dmitrychepel/dcf77/doc/dcf77_bb.png

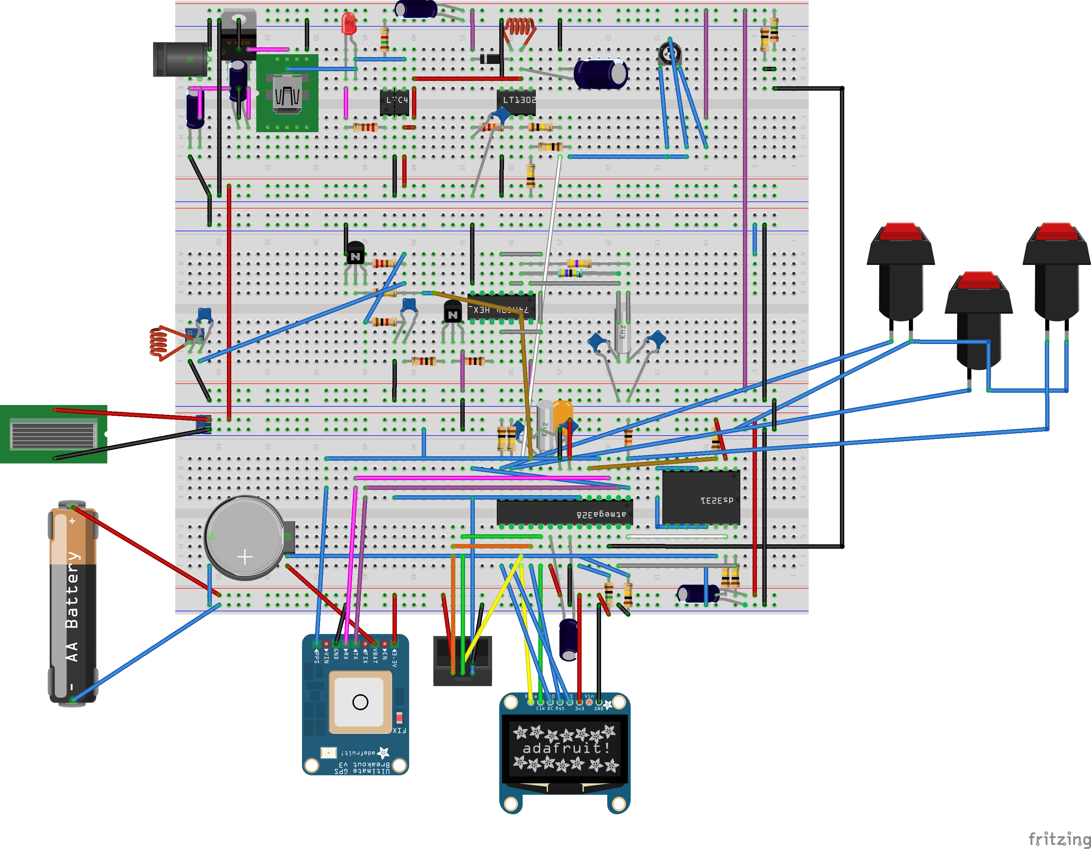
doc/dcf77_bb.png
