dmitrychepel/dcf77/doc/dcf77_печатная плата.png

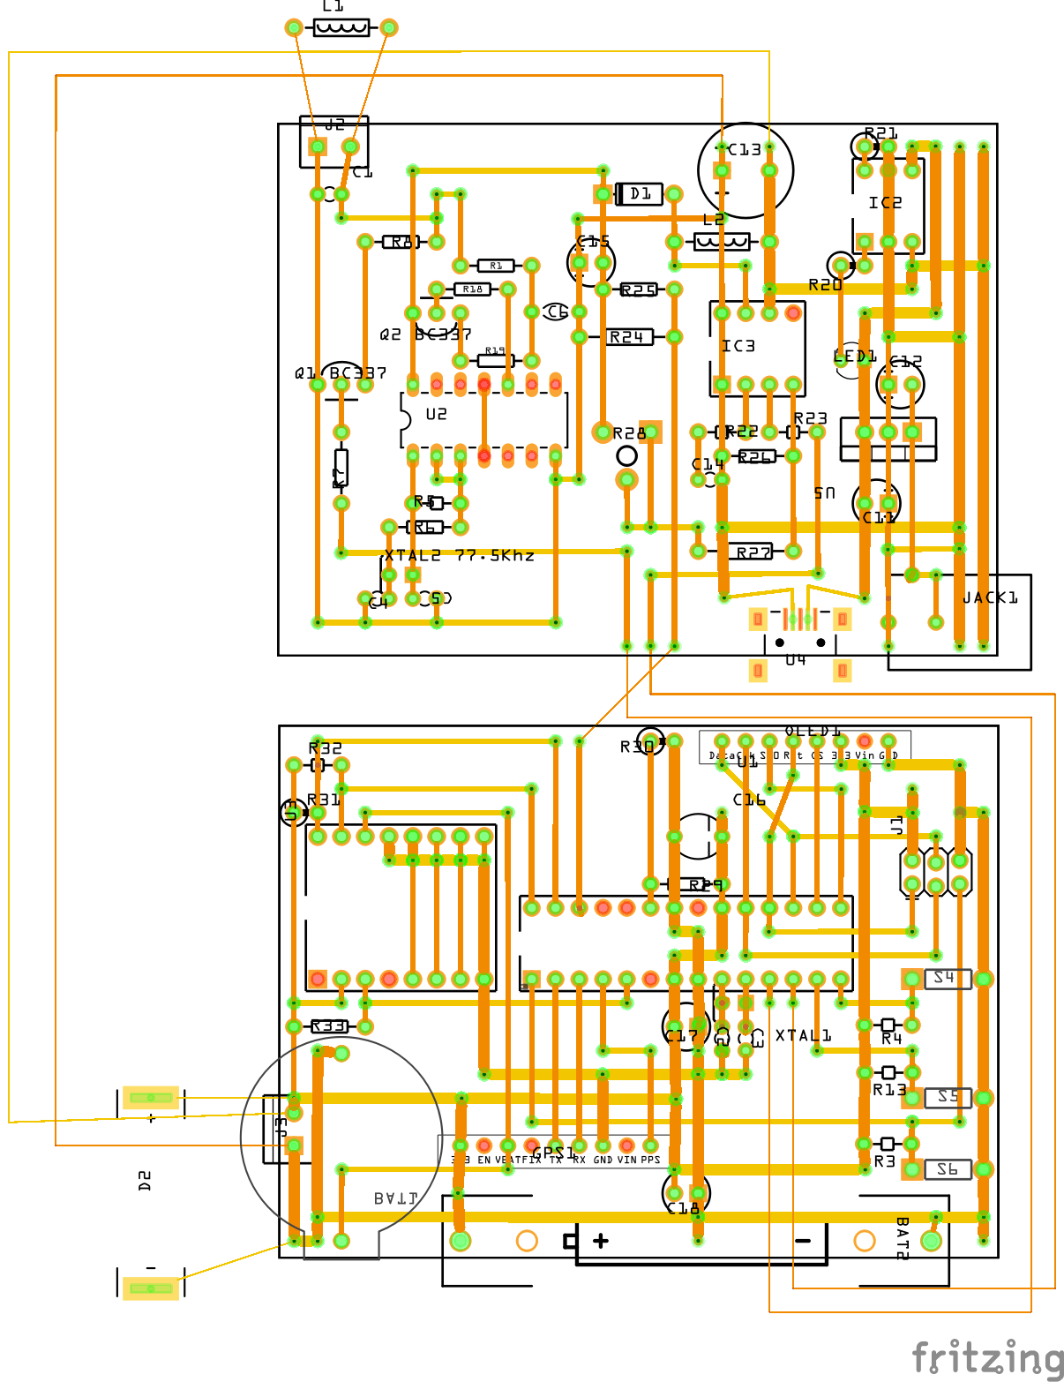
doc/dcf77_печатная плата.png
