dmitrychepel/dcf77/doc/dcf77_схема.png

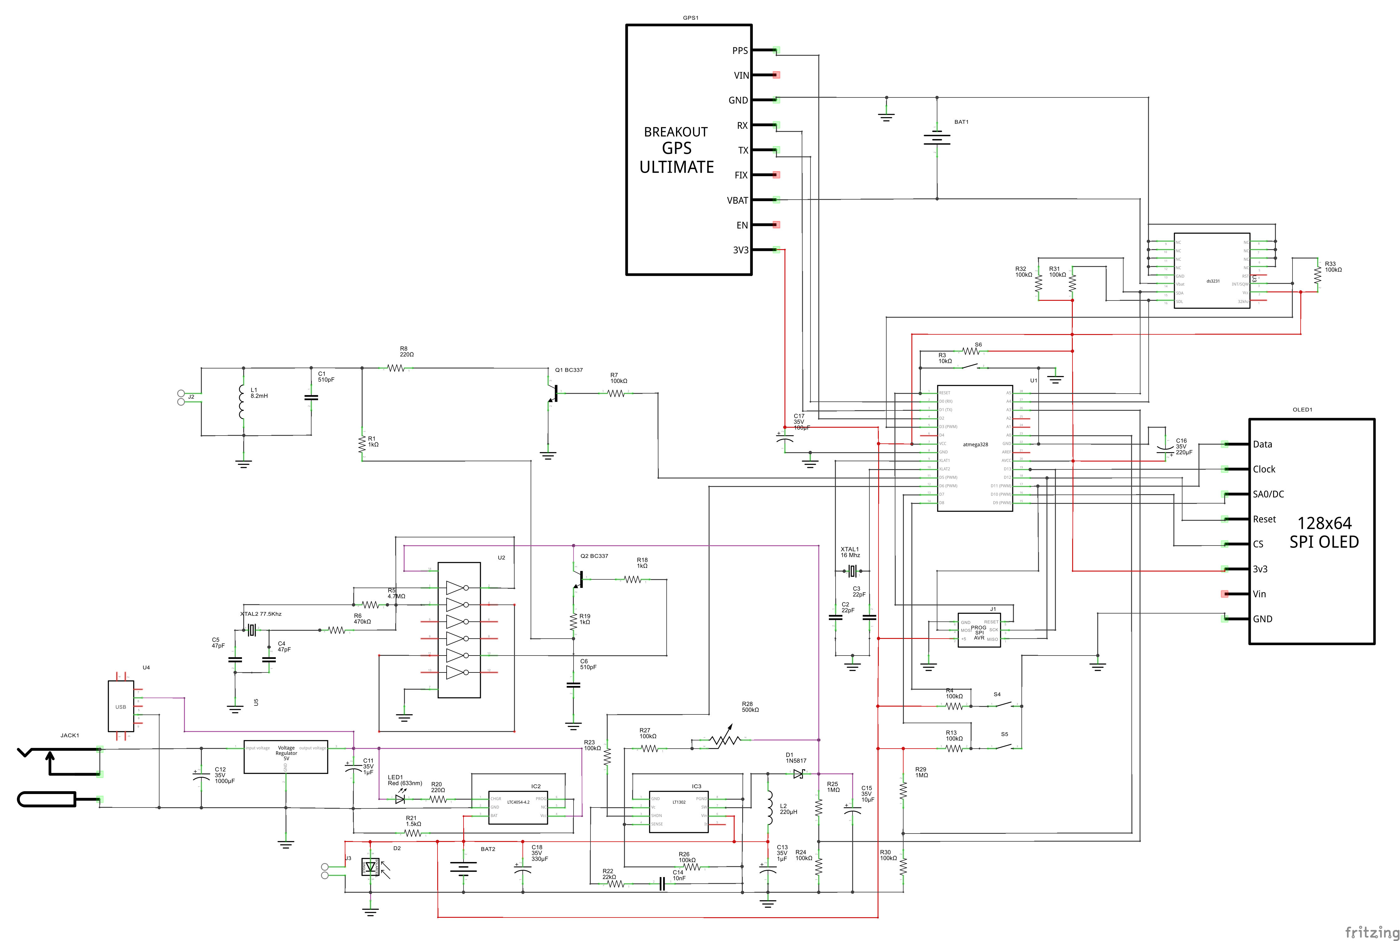
doc/dcf77_схема.png
