dmitrychepel/dcf77/schema/dcf77_v22_печатная плата.png

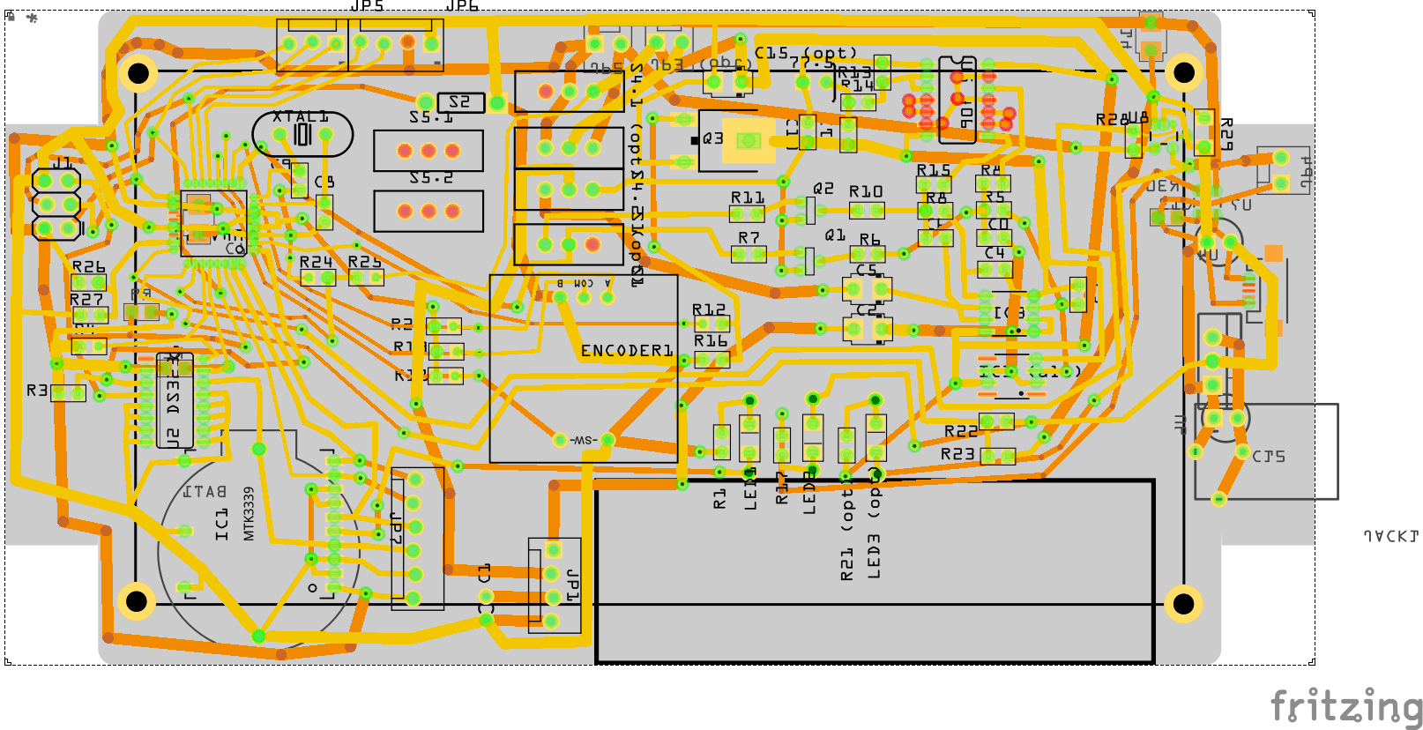
schema/dcf77_v22_печатная плата.png
