dmitrychepel/dcf77/doc/dcf77_first_step00.png

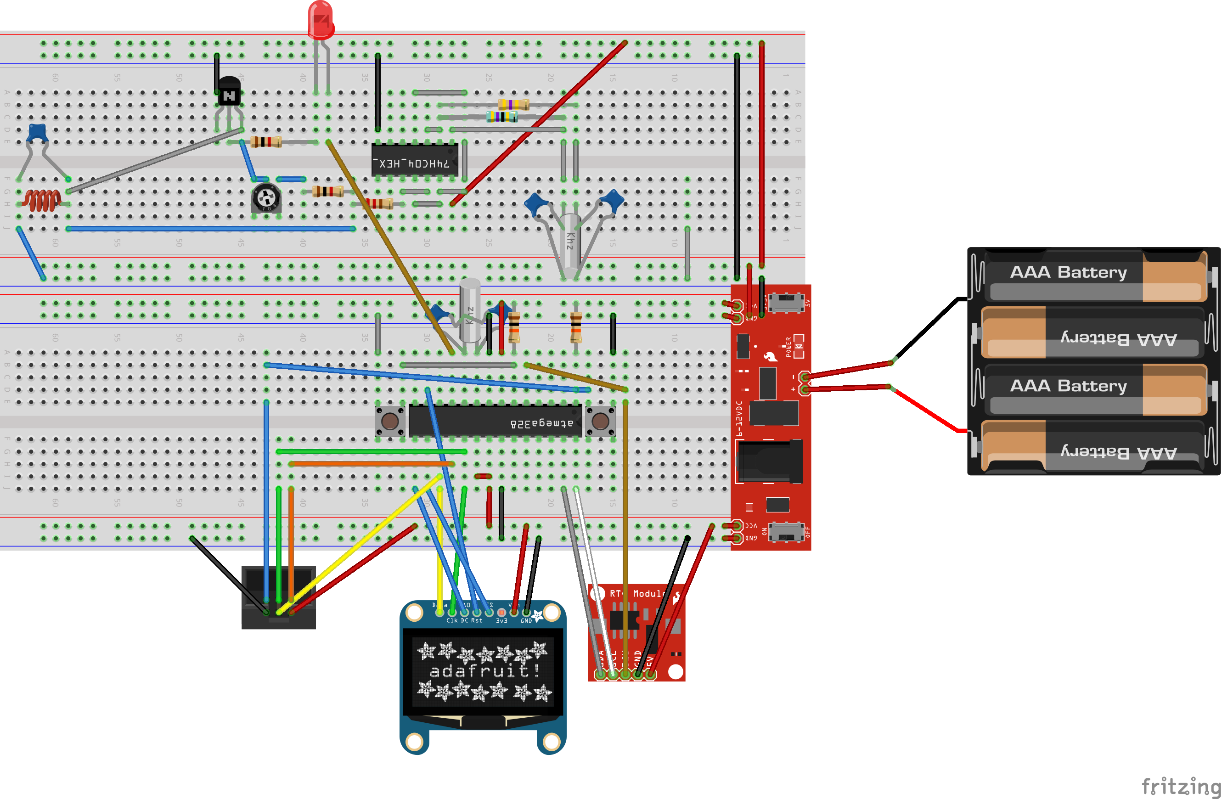
doc/dcf77_first_step00.png
