dmitrychepel/dcf77/doc/dcf77_first_step0.png

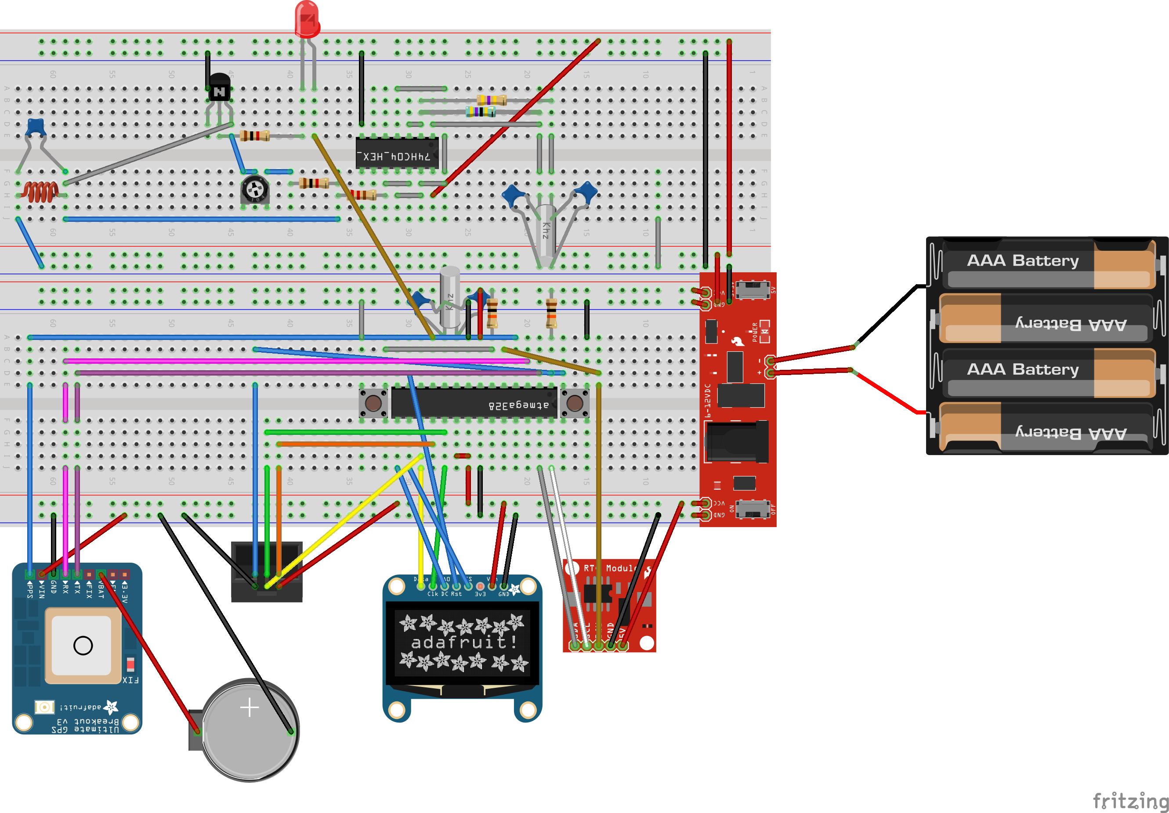
doc/dcf77_first_step0.png
