dmitrychepel/dcf77/doc/dcf77_first_step.png

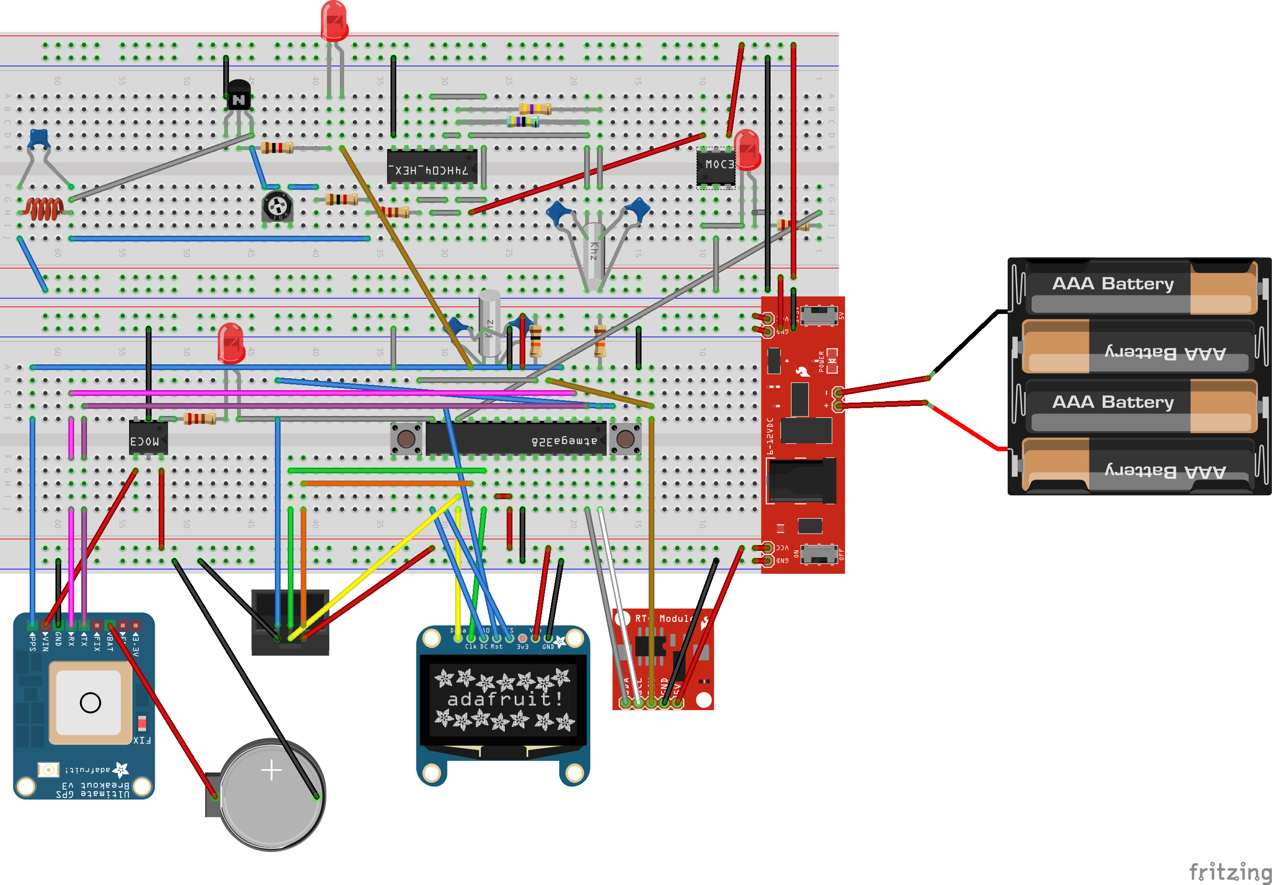
doc/dcf77_first_step.png
