dmitrychepel/dcf77/(list of files, drawings)

Other design files:
errors.pcb
ki/dcf77.dsn
schema/dcf77.fzz
schema/dcf77_.fzz
schema/dcf77_simple.fzz
schema/dcf77_v2.fzz
schema/dcf77_v22.fzz
