dmitrychepel/dcf77/ki/dcf77.kicad_pcb

## KiCad design ki/dcf77.kicad_pcb (2017-12-01)

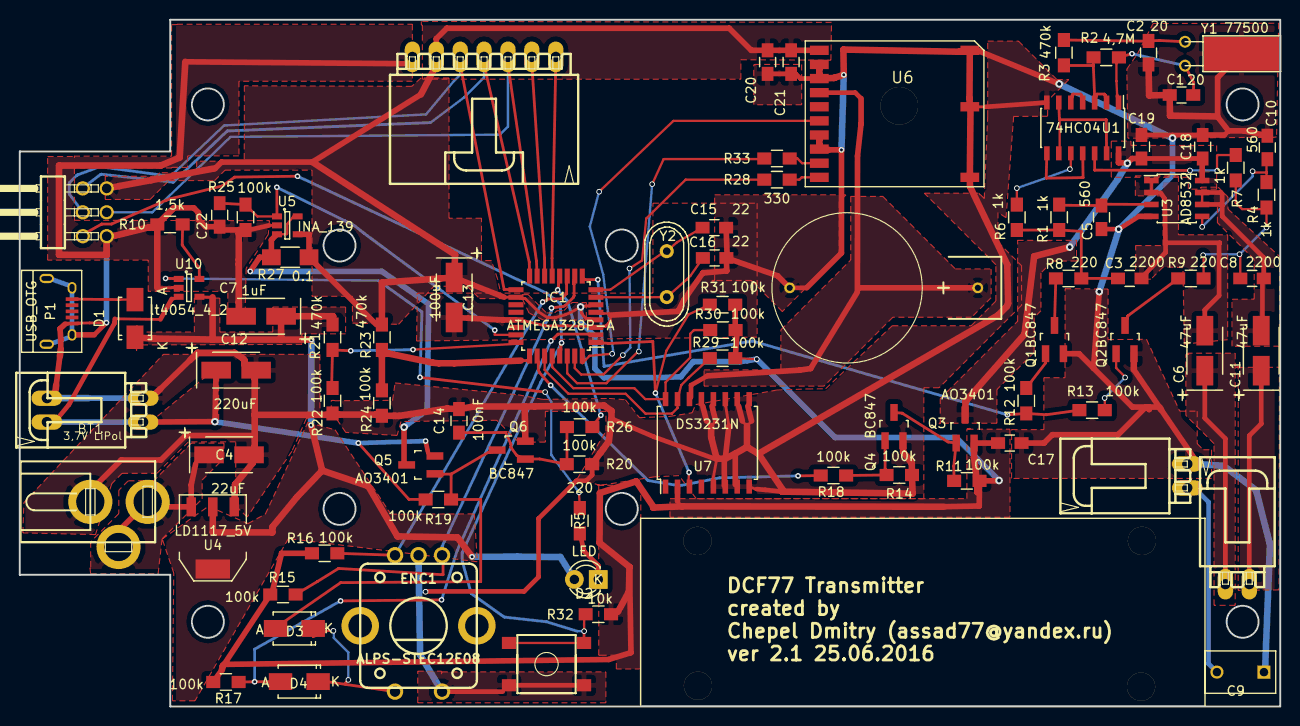
[picture p8: board dcf77.kicad_pcb from above]

Board: 2 copper layers, 134.0 x 73.0 mm, 86 parts (1 on the bottom side), 63 nets.

Parts:
BT1: 3,7V LiPol; con-molex-70553-02
C1, C2: 20; C_0805_HandSoldering
C3, C8: 2200; C_0805_HandSoldering
C4: 22uF; TantalC_SizeB_EIA-3528_HandSoldering
C5, C10: 560; C_0805_HandSoldering
C6, C11: 47uF; TantalC_SizeB_EIA-3528_HandSoldering
C7: 1uF; TantalC_SizeB_EIA-3528_HandSoldering
C9: 680pF; C_Disc_D7.5_P5
C12: 220uF; TantalC_SizeB_EIA-3528_HandSoldering
C13: 100uF; TantalC_SizeB_EIA-3528_HandSoldering
C14: 100nF; C_0805_HandSoldering
C15, C16: 22; C_0805_HandSoldering
C17, C22: 10uF; C_0805_HandSoldering
C18, C19: 4,7uF; C_0805_HandSoldering
C20: 1uF; C_0805_HandSoldering
C21: 0,1uF; C_0805_HandSoldering
CON1: AVR-ISP-6; atmel-1-AVR-ISP-6R
D1: D_Schottky; SMA_Standard
D2: LED; LED-3MM
D3, D4: D; SMA_Standard
ENC1: ALPS-STEC12E08
IC1: ATMEGA328P-A; TQFP-32_7x7mm_Pitch0.8mm
J1: JACK_2P; con-jack-DCJ0303
L1: 6mH; con-molex-70553-02
L2: 25 circles; con-molex-70553-02-real
P1: USB_OTG; USB_Micro-B
P2: CONN_BAT_EXT; con-molex-70553-02-real
P4: CONN_01X07; con-molex-70553-07
Q1, Q2, Q4, Q6: BC847; SOT-23_Handsoldering
Q3, Q5: AO3401; SOT-23_Handsoldering
R1, R4, R6, R7: 1k; R_0805_HandSoldering
R2: 4,7M; R_0805_HandSoldering
R3, R21, R23: 470k; R_0805_HandSoldering
R5, R8, R9: 220; R_0805_HandSoldering
R10: 1,5k; R_0805_HandSoldering
R11, R12, R13, R14, R15, R16, R17, R18, R19, R20, R22, R24, R25, R26, R29, R30, R31: 100k; R_0805_HandSoldering
R27: 0.1; R_1206_HandSoldering
R28, R33: 330; R_0805_HandSoldering
R32: 10k; R_0805_HandSoldering
SW1: Switch_DPST; switch-tact-DTSM-6-rot
U1: 74HC04; SOIC-14_3.9x8.7mm_Pitch1.27mm
U2: 3,7 V; sn2032-SN2032
U3: AD8532; SOIC-8_3.9x4.9mm_Pitch1.27mm
U4: LD1117_5V; SOT-223
U5: INA_139; SOT-23-5
U6: FGPMMOPA6C; FFGPMMOPA6C
U7: DS3231N; SOIC-16_7.5x10.3mm_Pitch1.27mm
U10: lt4054_4_2; SOT-23-5
Y1: 77500; Crystal_Watch
Y2: 8MHz; Crystal_HC49-U_Vertical

Connections:
/CLOCK: CON1.3, IC1.17, P4.5
/INPUT: IC1.25, R23.2, R24.1
/LED_CS: IC1.14, P4.2
/LED_DC: IC1.13, P4.1
/MISO: CON1.1, IC1.16, P4.4
/MOSI: CON1.4, IC1.15, P4.3
/PPS: IC1.32, U6.6
/ROT1: ENC1.A, IC1.10, R15.1
/ROT2: ENC1.B, IC1.11, R16.1
/RX: R28.1, U6.10
/R_BTN: D4.2, IC1.2, R17.1
/SDA: IC1.27, R29.2, U7.15
/SDL: IC1.28, R30.2, U7.16
/SQW: IC1.1, R31.2, U7.3
/TX: R33.1, U6.9
/VOLTAGE: IC1.24, R21.2, R22.1
CURRENT: C22.1, IC1.23, R25.1, U5.1
GND: BT1.2, C1.2, C2.2, C4.2, C5.2, C7.2, C9.1, C10.2, C12.2, C13.2, C14.2, C15.1, C16.2, C17.2, C18.2, C19.2, C20.2, C21.2, C22.2, CON1.6, ENC1.C, ENC1.SW1, IC1.3, IC1.5, IC1.21, J1.3, L1.2, P1.5, P1.6, P2.2, P4.7, Q1.2, Q2.2, Q4.2, Q6.2, R10.2, R14.2, R20.2, R22.2, R24.2, R25.2, SW1.1, SW1.3, U1.7, U2.2, U3.4, U4.1, U5.2, U6.2, U6.3, U6.7, U6.8, U6.11, U6.12, U6.13, U7.5, U7.6, U7.7, U7.8, U7.9, U7.10, U7.11, U7.12, U7.13, U10.2
unnamed: BT1.1, C12.1, P2.1, Q5.2, R19.2, U10.3
unnamed: C1.1, R2.2, U1.1, Y1.1
unnamed: C2.1, R3.2, Y1.2
unnamed: C3.1, R1.2, R6.1, R8.2
unnamed: C3.2, C6.2, U3.1, U3.2
unnamed: C4.1, J1.1, J1.2, U4.3
unnamed: C5.1, R1.1, U3.3
unnamed: C6.1, L2.1
unnamed: C8.1, R4.2, R7.1, R9.2
unnamed: C9.2, L1.1
unnamed: C10.1, R4.1, U3.5
unnamed: C11.1, L2.2
unnamed: C8.2, C11.2, U3.6, U3.7
unnamed: C14.1, Q6.1, R20.1, R26.2
unnamed: C15.2, IC1.8, Y2.1
unnamed: C16.1, IC1.7, Y2.2
unnamed: CON1.5, IC1.29, R32.2, SW1.2, SW1.4
unnamed: D1.2, P1.1
unnamed: D2.1, R5.2
unnamed: D3.1, D4.1, ENC1.SW2
unnamed: IC1.9, R12.1, R13.1
unnamed: IC1.30, R33.2
unnamed: IC1.31, R28.2
unnamed: Q1.1, R12.2
unnamed: Q1.3, R8.1
unnamed: Q2.1, R13.2
unnamed: Q2.3, R9.1
unnamed: Q3.1, Q4.3, R11.1
unnamed: Q4.1, R14.1, R18.2
unnamed: Q5.3, R27.2, U5.3, U5.5
unnamed: R2.1, R3.1, U1.2, U1.3
unnamed: R5.1, U10.1
unnamed: R6.2, U1.10
unnamed: R7.2, U1.12
unnamed: R10.1, U10.5
unnamed: U1.4, U1.5
unnamed: U1.8, U1.11
unnamed: U1.6, U1.9, U1.13
ON_BTN: D3.2, Q5.1, Q6.3, R19.1
PWR_ON: IC1.12, R26.1
RADIO_ON: IC1.26, R18.1
VAA: C7.1, D1.1, D2.2, R21.1, U4.2, U10.4
VCC: C13.1, C17.1, C20.1, C21.1, CON1.2, IC1.4, IC1.6, IC1.18, P4.6, Q3.2, R11.2, R15.2, R16.2, R17.2, R23.1, R27.1, R29.1, R30.1, R31.1, R32.1, U5.4, U6.1, U7.2
VDD: C18.1, C19.1, Q3.3, U1.14, U3.8
VEE: U2.1, U6.4, U7.14
