dmitrychepel/dcf77/src/dcf77/MyGPS.h

/*
TinyGPS - a small GPS library for Arduino providing basic NMEA parsing
Based on work by and "distance_to" and "course_to" courtesy of Maarten Lamers.
Suggestion to add satellites(), course_to(), and cardinal(), by Matt Monson.
Precision improvements suggested by Wayne Holder.
Copyright (C) 2008-2013 Mikal Hart
All rights reserved.

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
You should have received a copy of the GNU Lesser General Public
License along with this library; if not, write to the Free Software
Foundation, Inc., 51 Franklin St, Fifth Floor, Boston, MA  02110-1301  USA
*/

#ifndef TinyGPS_h
#define TinyGPS_h

#if defined(ARDUINO) && ARDUINO >= 100
#include "Arduino.h"
#else
#include "WProgram.h"
#endif

#include <stdlib.h>

#define _GPS_VERSION 13 // software version of this library
#define _GPS_KMPH_PER_KNOT 1.852
// #define _GPS_NO_STATS

class MyGPS
{
public:
  enum {
    GPS_INVALID_AGE = 0xFFFFFFFF,      GPS_INVALID_ANGLE = 999999999, 
    GPS_INVALID_ALTITUDE = 999999999,  GPS_INVALID_DATE = 0,
    GPS_INVALID_TIME = 0xFFFFFFFF,		 GPS_INVALID_SPEED = 999999999, 
    GPS_INVALID_FIX_TIME = 0xFFFFFFFF, GPS_INVALID_SATELLITES = 0xFF,
    GPS_INVALID_HDOP = 0xFFFFFFFF
  };

  static const float GPS_INVALID_F_ANGLE, GPS_INVALID_F_ALTITUDE, GPS_INVALID_F_SPEED;

  MyGPS(Stream& n);

  bool proeccess_one();
  bool has_data();
  bool encode(char c); // process one character received from GPS

  // lat/long in MILLIONTHs of a degree and age of fix in milliseconds
  // (note: versions 12 and earlier gave lat/long in 100,000ths of a degree.
  void get_position(long *latitude, long *longitude, unsigned long *last_fix = 0);

  // date as ddmmyy, time as hhmmsscc, and age in milliseconds
  void get_datetime(unsigned long *date, unsigned long *time, unsigned long *last_fix = 0);

  // signed altitude in centimeters (from GPGGA sentence)
  inline long altitude() { return _altitude; }

  // course in last full GPRMC sentence in 100th of a degree
  inline unsigned long course() { return _course; }

  // speed in last full GPRMC sentence in 100ths of a knot
  inline unsigned long speed() { return _speed; }

  // satellites used in last full GPGGA sentence
  inline unsigned short satellites() { return _numsats==GPS_INVALID_SATELLITES?0:_numsats; }

  // horizontal dilution of precision in 100ths
  inline unsigned long hdop() { return _hdop; }

  void f_get_position(float *latitude, float *longitude, unsigned long *last_fix = 0);
  void crack_datetime(byte *year, byte *month, byte *day, 
    byte *hour, byte *minute, byte *second, byte *hundredths = 0, unsigned long *last_fix = 0);
  float f_altitude();
  float f_course();
  float f_speed_kmph();

  void send_command(const char *str);
  bool standby();
  bool wakeup();
  bool cold_restart();

  static int library_version() { return _GPS_VERSION; }

private:
  enum {_GPS_SENTENCE_GPGGA, _GPS_SENTENCE_GPRMC, _GPS_SENTENCE_OTHER};

  // properties
  unsigned long _time, _new_time;
  unsigned long _date, _new_date;
  long _latitude, _new_latitude;
  long _longitude, _new_longitude;
  long _altitude, _new_altitude;
  unsigned long  _speed, _new_speed;
  unsigned long  _course, _new_course;
  unsigned long  _hdop, _new_hdop;
  unsigned short _numsats, _new_numsats;

  unsigned long _last_time_fix, _new_time_fix;
  unsigned long _last_position_fix, _new_position_fix;

  // parsing state variables
  byte _parity;
  bool _is_checksum_term;
  char _term[15];
  byte _sentence_type;
  byte _term_number;
  byte _term_offset;
  bool _gps_data_good;
  bool _standby;
  Stream& _serial;

  // internal utilities
  int from_hex(char a);
  unsigned long parse_decimal();
  unsigned long parse_degrees();
  bool term_complete();
  bool gpsisdigit(char c) { return c >= '0' && c <= '9'; }
  long gpsatol(const char *str);
  int gpsstrcmp(const char *str1, const char *str2);
};

#if !defined(ARDUINO) 
// Arduino 0012 workaround
#undef int
#undef char
#undef long
#undef byte
#undef float
#undef abs
#undef round 
#endif

#endif
